DanielPedroElias/Microscopia-Openflerure---UFMT/ImpressaoBaixoCusto/PecasEditadas/actuator_assembly_toolsPart2_1.stl

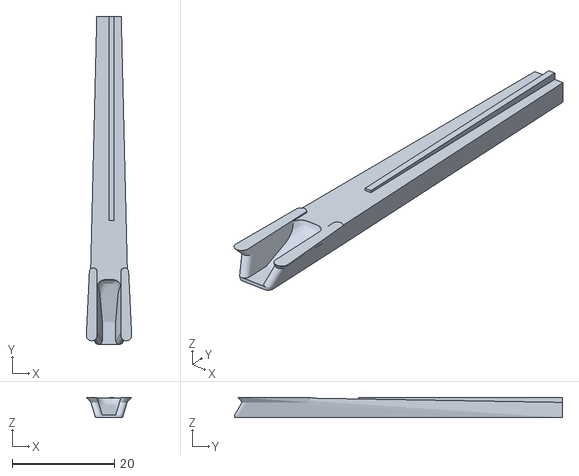
[picture p1: CAD file, 2026-11-10]
ImpressaoBaixoCusto/PecasEditadas/actuator_assembly_toolsPart2_1.stl
8.90 x 64.2 x 4.00
