DanielPedroElias/Microscopia-Openflerure---UFMT/ImpressãoMicManual/PecasEditadas/actuator_assembly_toolsPart1.stl

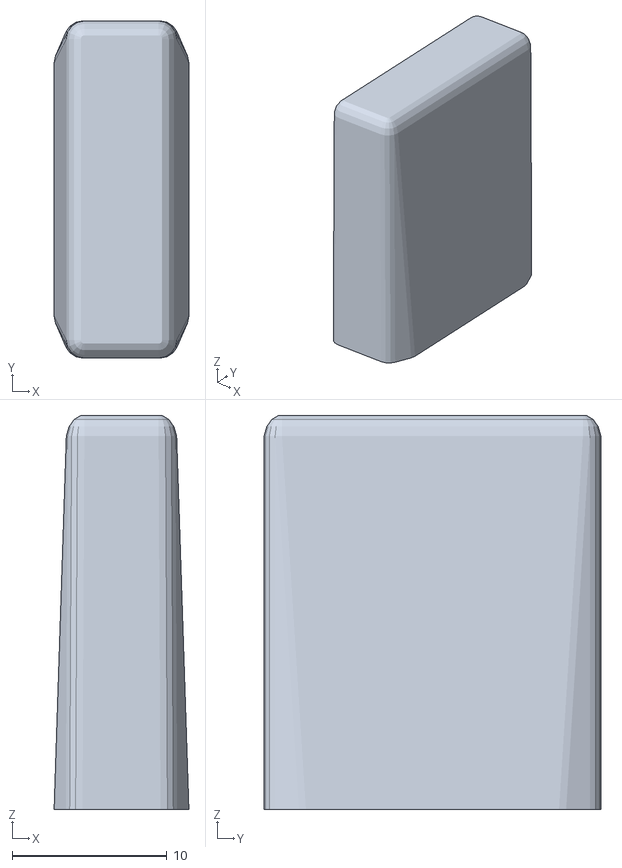
[picture p2: CAD file, 2026-11-10]
ImpressãoMicManual/PecasEditadas/actuator_assembly_toolsPart1.stl
8.72 x 21.8 x 25.5
