DanielPedroElias/Microscopia-Openflerure---UFMT/ImpressãoMicManual/PecasEditadas/actuator_assembly_toolsPart3.stl

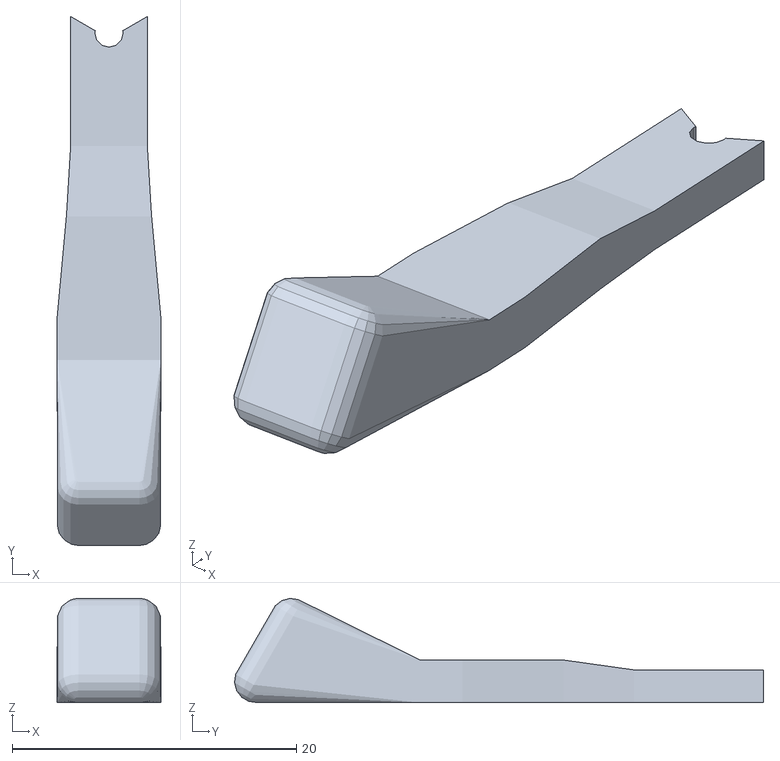
[picture p3: CAD file, 2026-11-10]
ImpressãoMicManual/PecasEditadas/actuator_assembly_toolsPart3.stl
7.30 x 37.2 x 7.33
