DanielPedroElias/Microscopia-Openflerure---UFMT/ImpressaoBaixoCusto/models/actuator_assembly_tools.stl

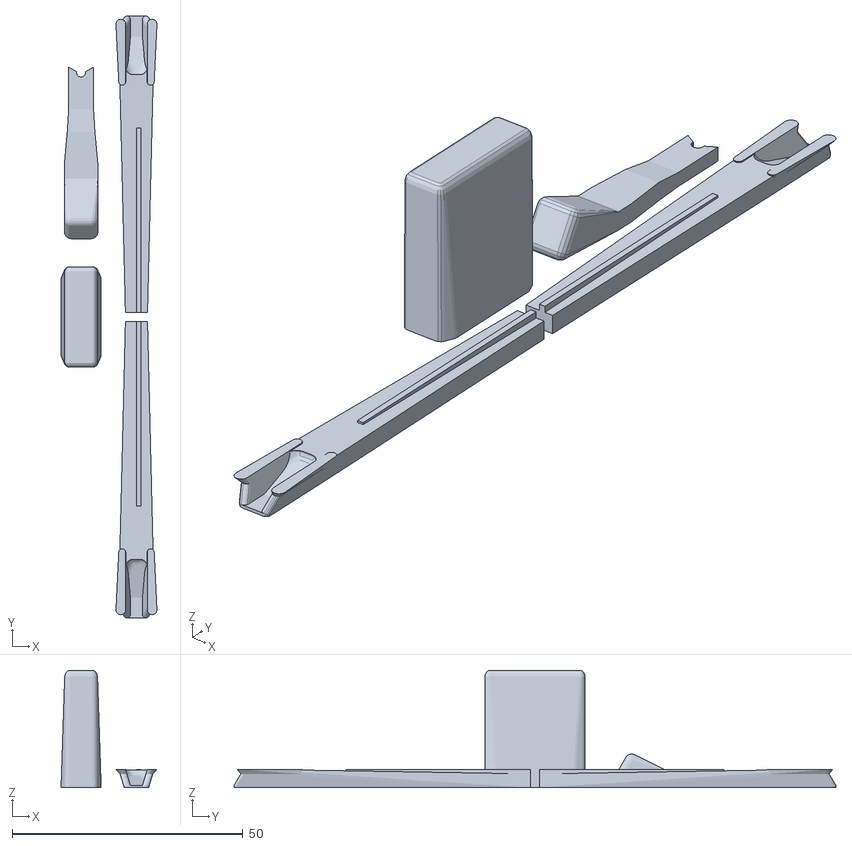
[picture p4: CAD file, 2026-11-10]
ImpressaoBaixoCusto/models/actuator_assembly_tools.stl
20.8 x 130.5 x 25.5
