DanielPedroElias/Microscopia-Openflerure---UFMT/ImpressãoMicManual/models/main_body_manual.stl

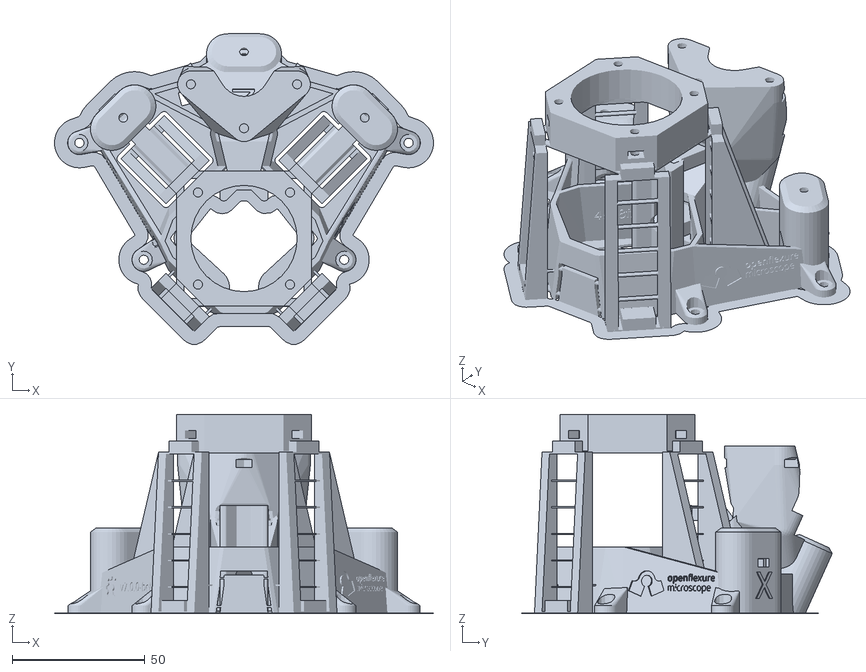
[picture p5: CAD file, 2026-11-10]
ImpressãoMicManual/models/main_body_manual.stl
142.6 x 116.8 x 75.0
