DanielPedroElias/Microscopia-Openflerure---UFMT/ImpressaoBaixoCusto/models/main_body.stl

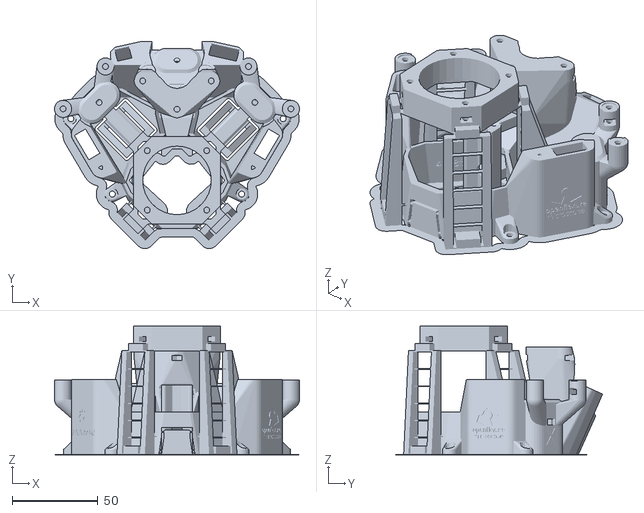
[picture p6: CAD file, 2026-11-10]
ImpressaoBaixoCusto/models/main_body.stl
142.9 x 120.9 x 75.0
