DanielPedroElias/Microscopia-Openflerure---UFMT/ImpressaoBaixoCusto/adaptacoes/condenser_led_holder.stl

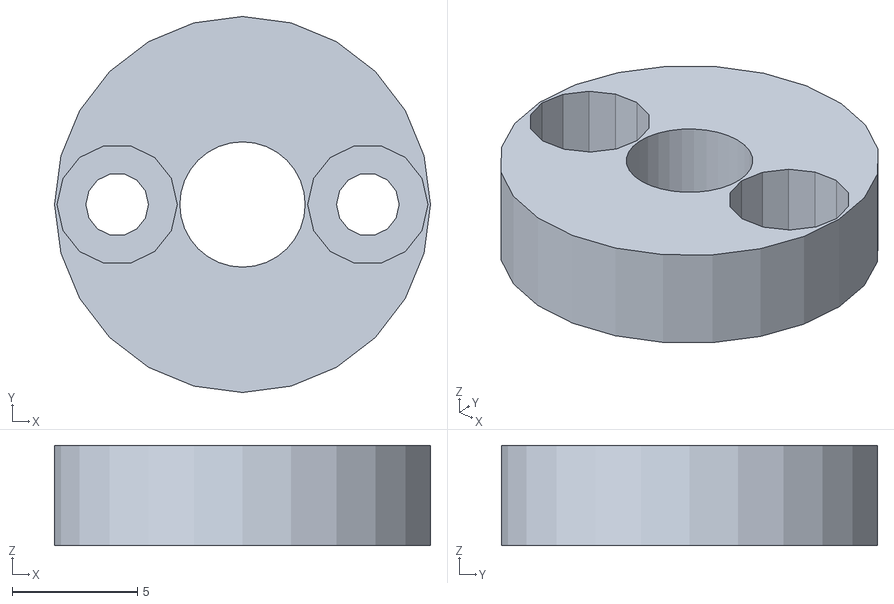
[picture p7: CAD file, 2026-11-10]
ImpressaoBaixoCusto/adaptacoes/condenser_led_holder.stl
15.0 x 15.0 x 4.00
