DanielPedroElias/Microscopia-Openflerure---UFMT/ImpressaoBaixoCusto/models/condenser.stl

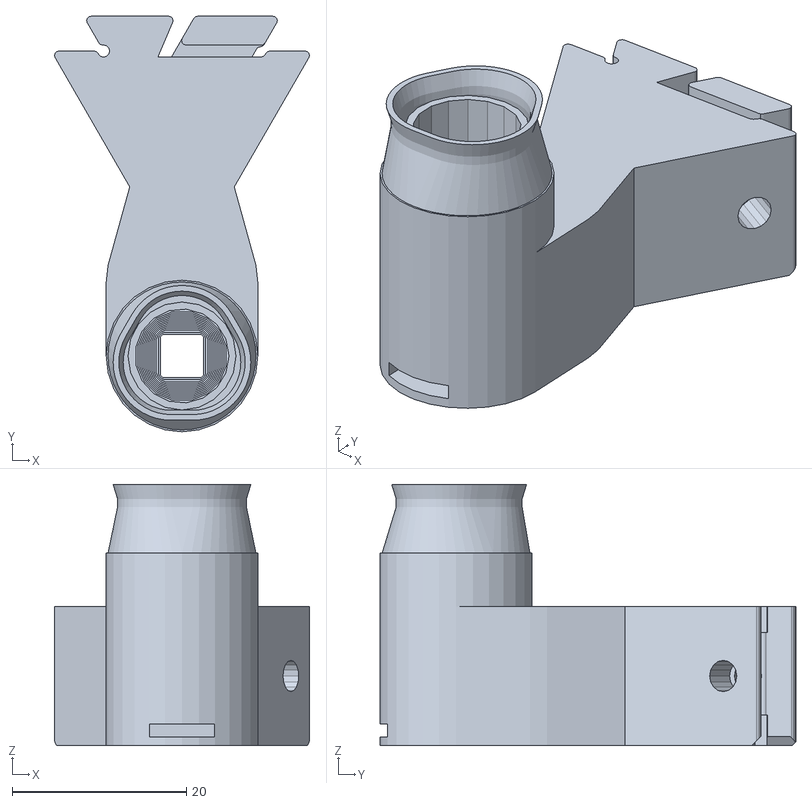
[picture p8: CAD file, 2026-11-10]
ImpressaoBaixoCusto/models/condenser.stl
29.3 x 47.7 x 30.0
