DanielPedroElias/Microscopia-Openflerure---UFMT/ImpressãoMicManual/models/feet.stl

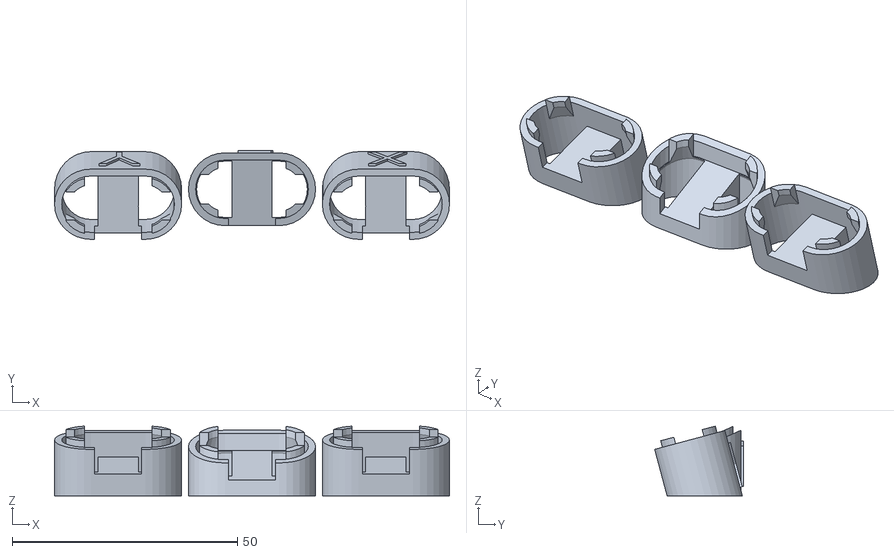
[picture p9: CAD file, 2026-11-10]
ImpressãoMicManual/models/feet.stl
87.6 x 19.7 x 15.5
