DanielPedroElias/Microscopia-Openflerure---UFMT/ImpressãoMicManual/PecasEditadas/feetX.stl

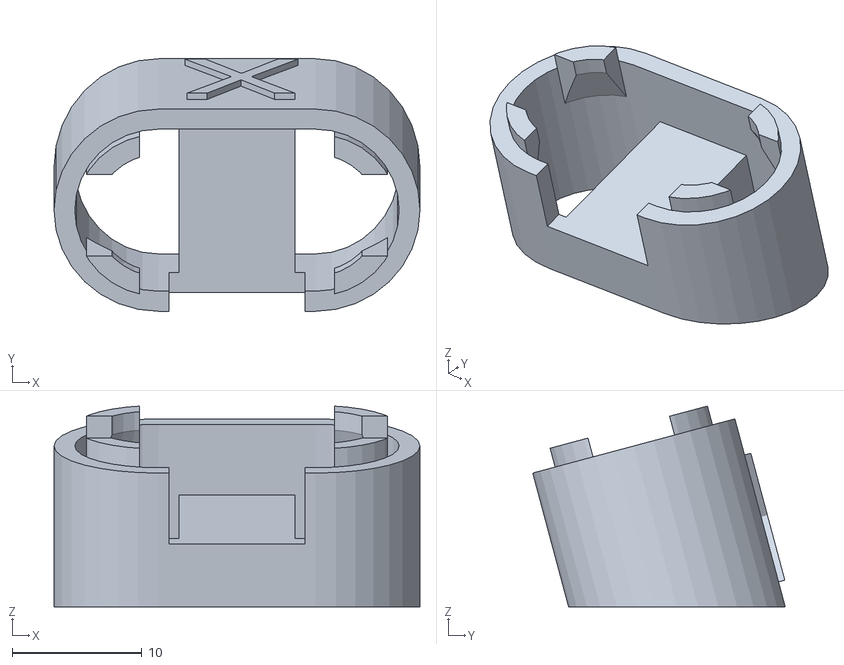
[picture p10: CAD file, 2026-11-10]
ImpressãoMicManual/PecasEditadas/feetX.stl
28.2 x 19.5 x 15.5
