DanielPedroElias/Microscopia-Openflerure---UFMT/ImpressaoBaixoCusto/adaptacoes/nano_converter_plate_gripper.stl

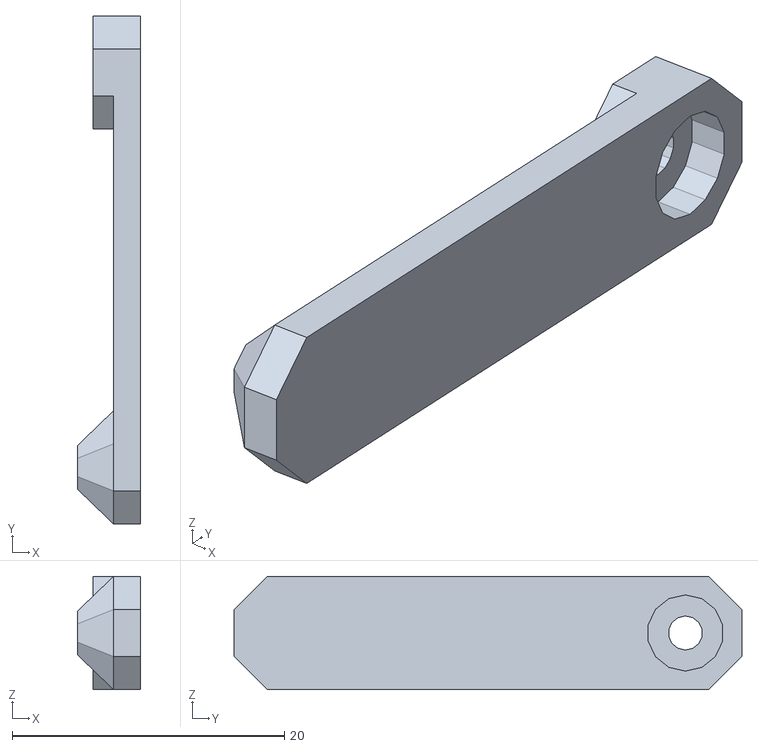
[picture p11: CAD file, 2026-11-10]
ImpressaoBaixoCusto/adaptacoes/nano_converter_plate_gripper.stl
4.66 x 37.3 x 8.31
