DanielPedroElias/Microscopia-Openflerure---UFMT/ImpressaoBaixoCusto/models/small_gears.stl

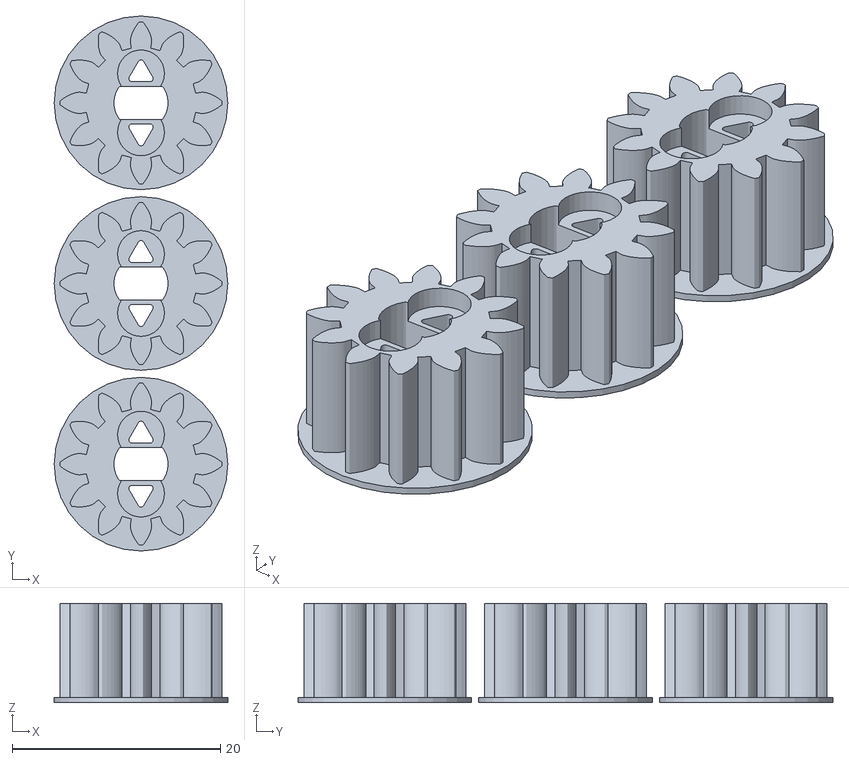
[picture p12: CAD file, 2026-11-10]
ImpressaoBaixoCusto/models/small_gears.stl
16.7 x 51.3 x 9.50
