DanielPedroElias/Microscopia-Openflerure---UFMT/ImpressaoBaixoCusto/PecasEditadas/GearToolsPart1.stl

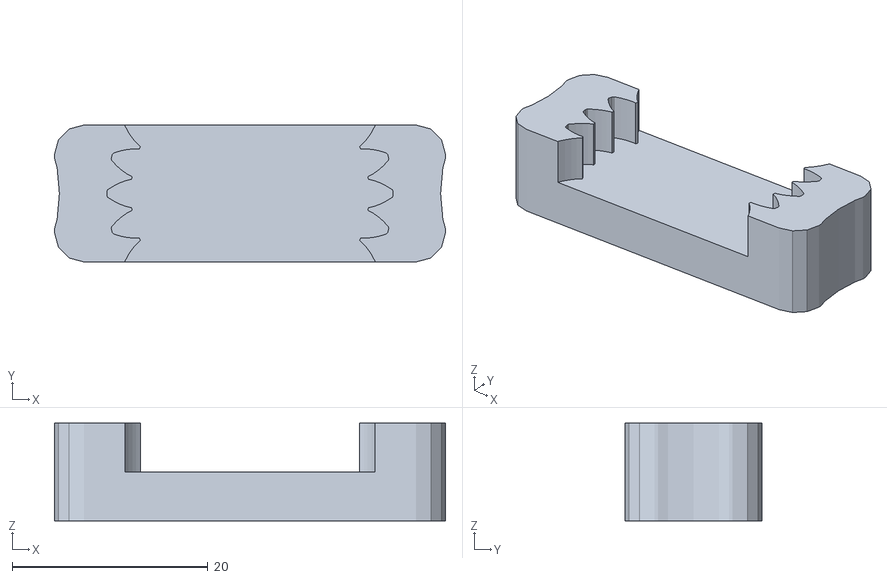
[picture p13: CAD file, 2026-11-10]
ImpressaoBaixoCusto/PecasEditadas/GearToolsPart1.stl
40.0 x 14.0 x 10.0
