DanielPedroElias/Microscopia-Openflerure---UFMT/ImpressaoBaixoCusto/adaptacoes/nano_converter_plate-pi4.stl

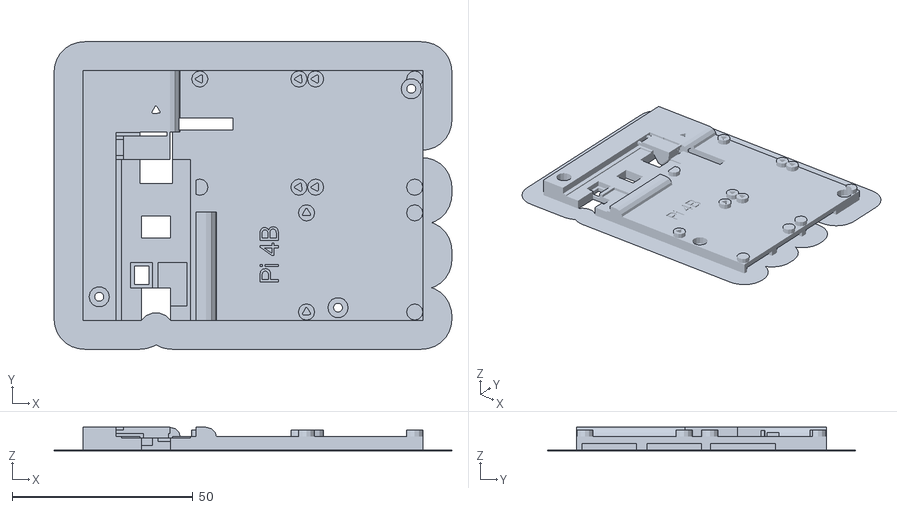
[picture p14: CAD file, 2026-11-10]
ImpressaoBaixoCusto/adaptacoes/nano_converter_plate-pi4.stl
110.0 x 85.0 x 6.50
