DanielPedroElias/Microscopia-Openflerure---UFMT/ImpressaoBaixoCusto/PecasEditadas/cable_tidiesPart2_1.stl

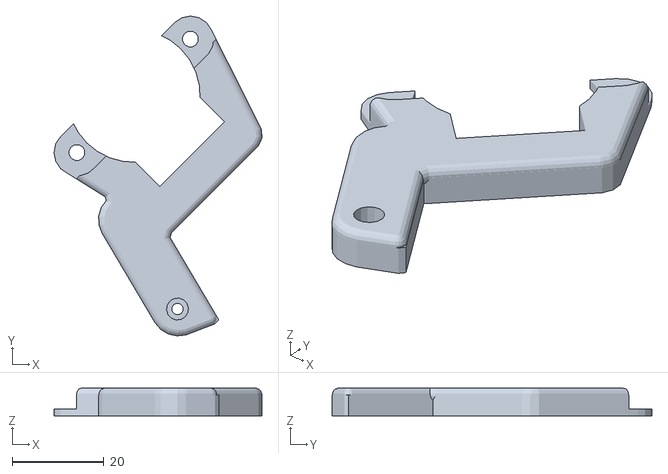
[picture p15: CAD file, 2026-11-10]
ImpressaoBaixoCusto/PecasEditadas/cable_tidiesPart2_1.stl
45.4 x 69.7 x 6.02
