DanielPedroElias/Microscopia-Openflerure---UFMT/ImpressãoMicManual/models/simple_post_stand.stl

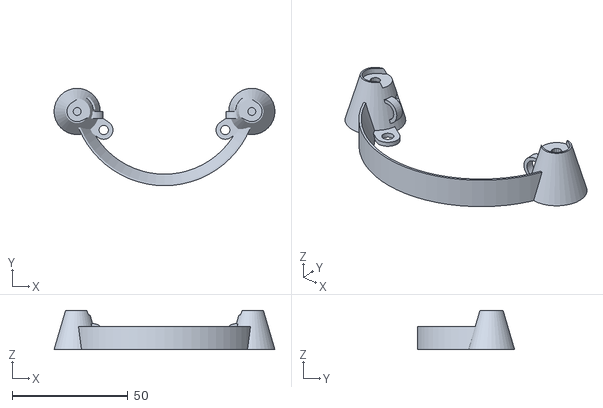
[picture p16: CAD file, 2026-11-10]
ImpressãoMicManual/models/simple_post_stand.stl
95.4 x 42.1 x 17.0
