DanielPedroElias/Microscopia-Openflerure---UFMT/ImpressãoMicManual/PecasEditadas/feetZ.stl

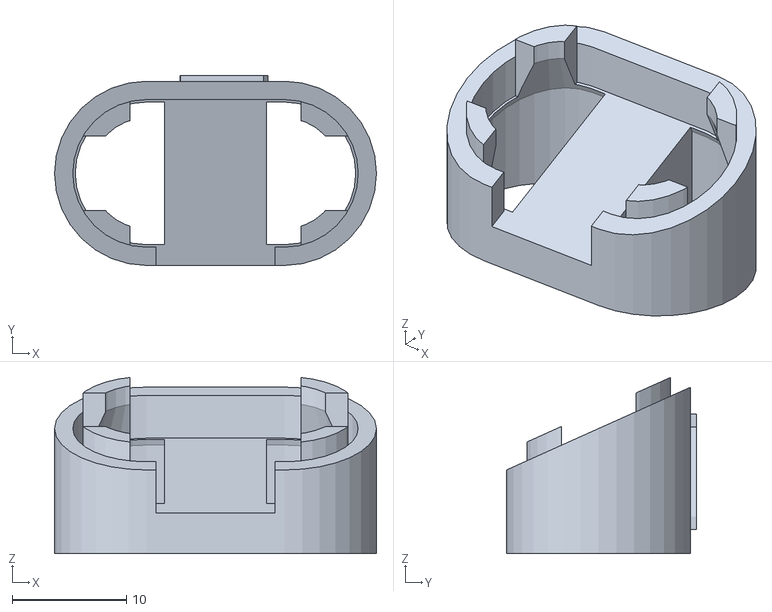
[picture p17: CAD file, 2026-11-10]
ImpressãoMicManual/PecasEditadas/feetZ.stl
28.2 x 16.6 x 15.4
