DanielPedroElias/Microscopia-Openflerure---UFMT/ImpressaoBaixoCusto/models/illumination_dovetail.stl

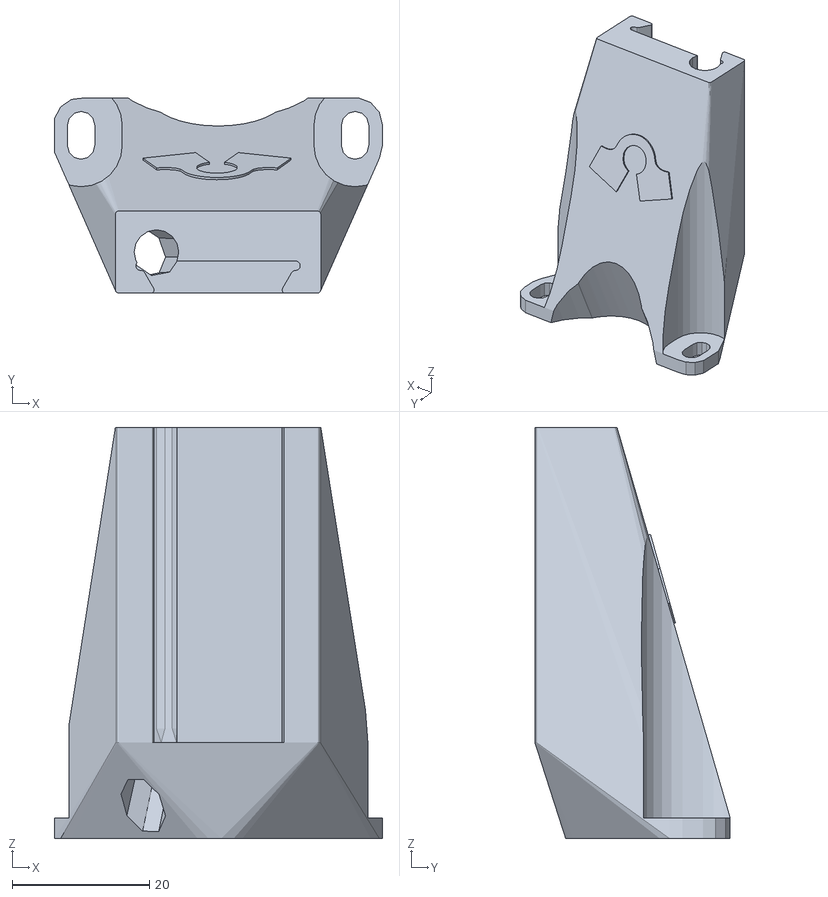
[picture p18: CAD file, 2026-11-10]
ImpressaoBaixoCusto/models/illumination_dovetail.stl
47.9 x 28.5 x 60.0
