DanielPedroElias/Microscopia-Openflerure---UFMT/ImpressãoMicManual/models/condenser_board_spacer.stl

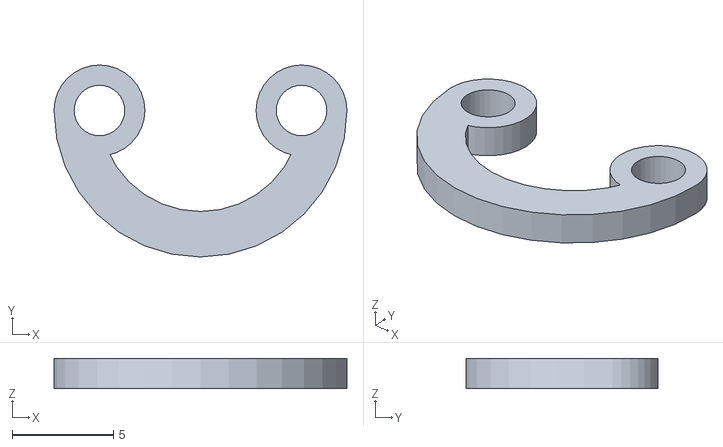
[picture p19: CAD file, 2026-11-10]
ImpressãoMicManual/models/condenser_board_spacer.stl
14.5 x 9.50 x 1.50
