DanielPedroElias/Microscopia-Openflerure---UFMT/ImpressãoMicManual/models/lens_tool.stl

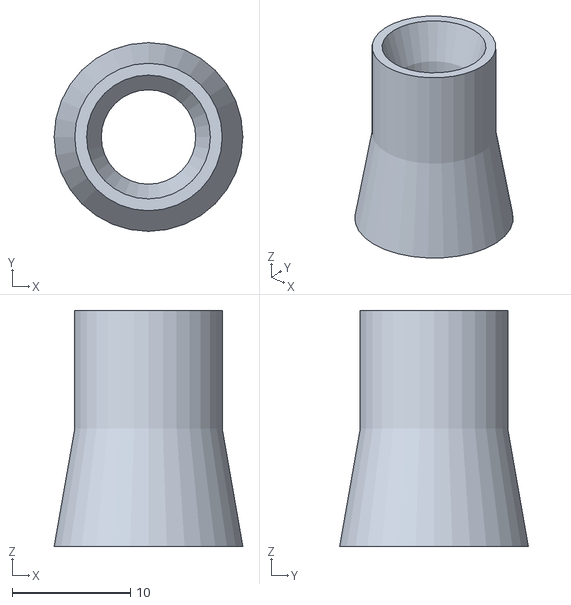
[picture p20: CAD file, 2026-11-10]
ImpressãoMicManual/models/lens_tool.stl
16.0 x 16.0 x 20.0
