DanielPedroElias/Microscopia-Openflerure---UFMT/ImpressaoBaixoCusto/models/camera_platform_picamera_2_pilens.stl

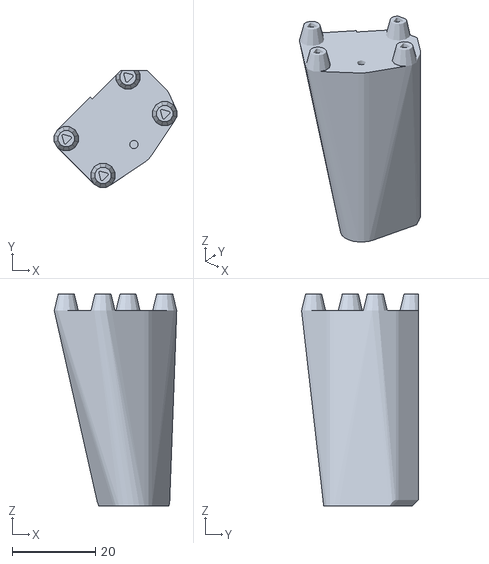
[picture p21: CAD file, 2026-11-10]
ImpressaoBaixoCusto/models/camera_platform_picamera_2_pilens.stl
29.5 x 28.1 x 51.0
