DanielPedroElias/Microscopia-Openflerure---UFMT/ImpressaoBaixoCusto/PecasEditadas/cable_tidiesPart1.stl

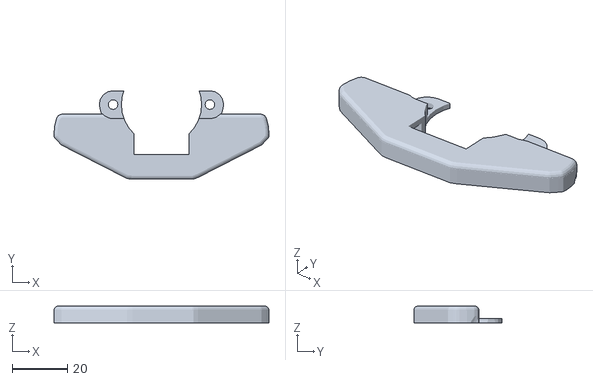
[picture p22: CAD file, 2026-11-10]
ImpressaoBaixoCusto/PecasEditadas/cable_tidiesPart1.stl
77.7 x 32.0 x 6.02
