DanielPedroElias/Microscopia-Openflerure---UFMT/ImpressãoMicManual/models/camera_platform_c270.stl

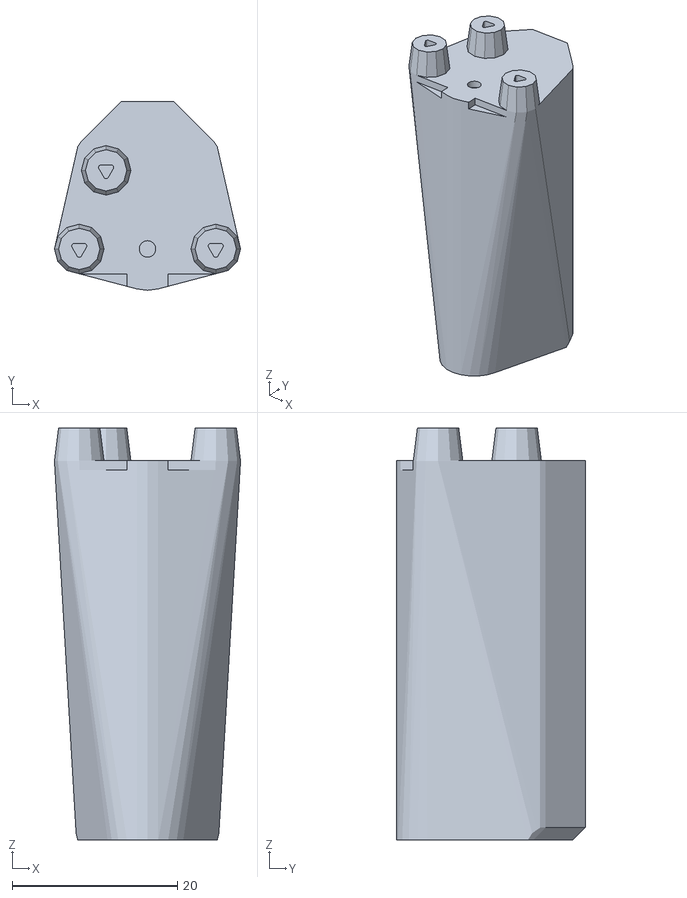
[picture p23: CAD file, 2026-11-10]
ImpressãoMicManual/models/camera_platform_c270.stl
22.5 x 22.8 x 49.8
