DanielPedroElias/Microscopia-Openflerure---UFMT/ImpressaoBaixoCusto/models/electronics_drawer-pi4_sanga_stack_11mm.stl

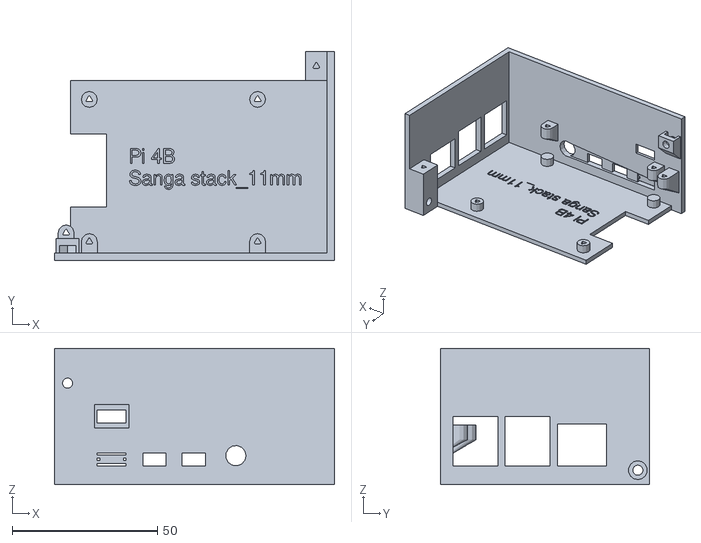
[picture p24: CAD file, 2026-11-10]
ImpressaoBaixoCusto/models/electronics_drawer-pi4_sanga_stack_11mm.stl
96.5 x 72.0 x 47.0
