DanielPedroElias/Microscopia-Openflerure---UFMT/ImpressaoBaixoCusto/PecasEditadas/uniqueSmallGear.stl

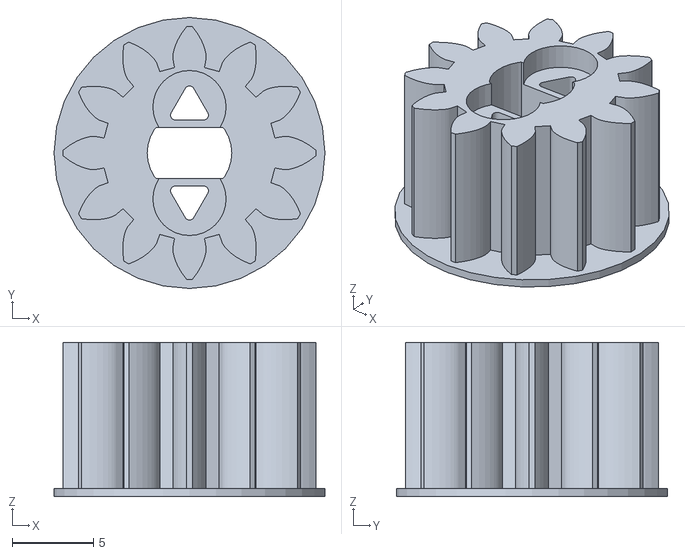
[picture p25: CAD file, 2026-11-10]
ImpressaoBaixoCusto/PecasEditadas/uniqueSmallGear.stl
16.7 x 16.7 x 9.50
