DanielPedroElias/Microscopia-Openflerure---UFMT/ImpressãoMicManual/models/microscope_stand_no_pi.stl

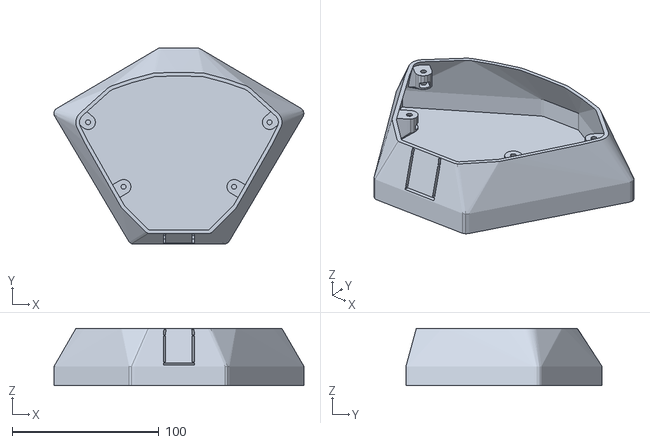
[picture p26: CAD file, 2026-11-10]
ImpressãoMicManual/models/microscope_stand_no_pi.stl
170.6 x 133.9 x 39.0
