DanielPedroElias/Microscopia-Openflerure---UFMT/ImpressãoMicManual/PecasEditadas/Uniquethumbwheels.stl

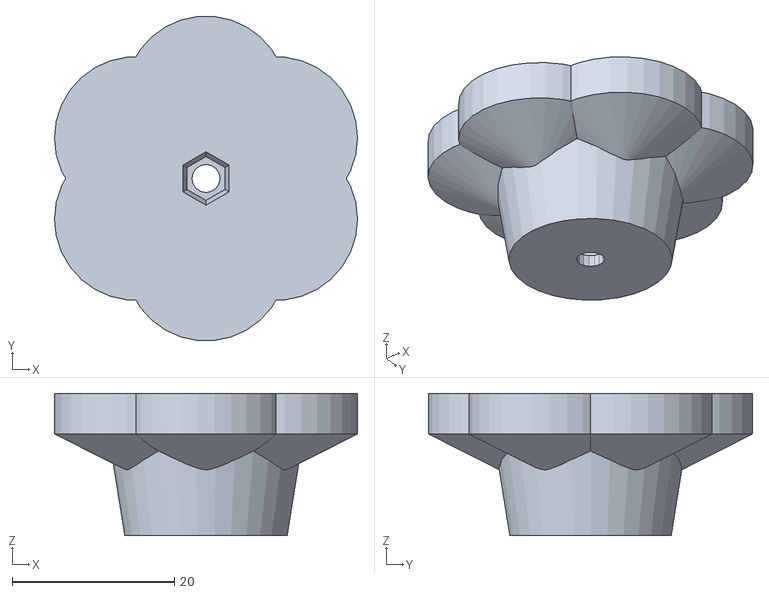
[picture p27: CAD file, 2026-11-10]
ImpressãoMicManual/PecasEditadas/Uniquethumbwheels.stl
37.3 x 39.9 x 17.5
