DanielPedroElias/Microscopia-Openflerure---UFMT/ImpressaoBaixoCusto/models/lens_spacer_picamera_2_pilens.stl

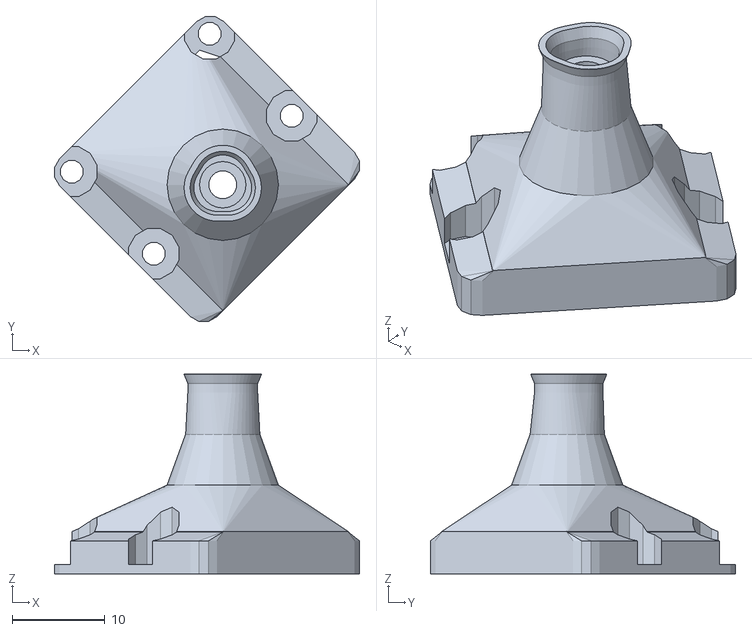
[picture p28: CAD file, 2026-11-10]
ImpressaoBaixoCusto/models/lens_spacer_picamera_2_pilens.stl
32.9 x 32.9 x 21.5
