DanielPedroElias/Microscopia-Openflerure---UFMT/ImpressaoBaixoCusto/PecasEditadas/uniqueLargeGear.stl

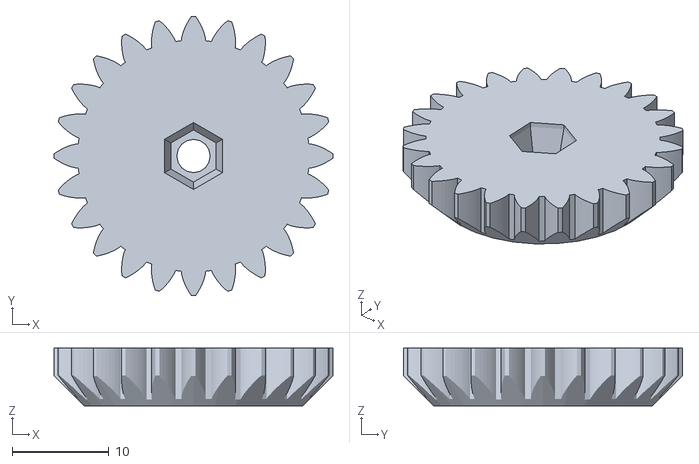
[picture p29: CAD file, 2026-11-10]
ImpressaoBaixoCusto/PecasEditadas/uniqueLargeGear.stl
28.9 x 28.9 x 6.00
