DanielPedroElias/Microscopia-Openflerure---UFMT/ImpressaoBaixoCusto/models/large_gears.stl

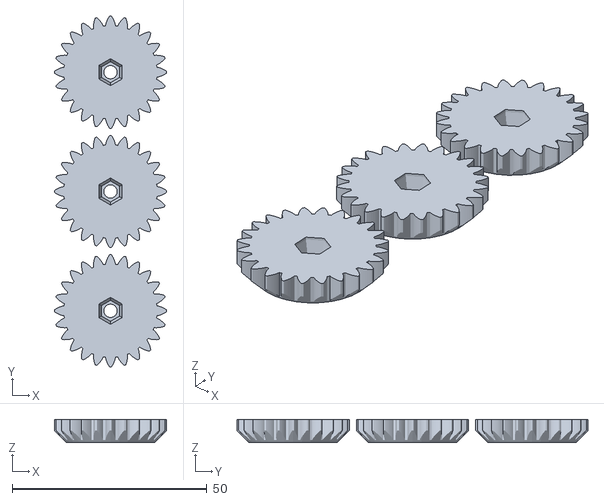
[picture p30: CAD file, 2026-11-10]
ImpressaoBaixoCusto/models/large_gears.stl
28.9 x 90.2 x 6.00
