DanielPedroElias/Microscopia-Openflerure---UFMT/ImpressãoMicManual/models/thumbwheels.stl

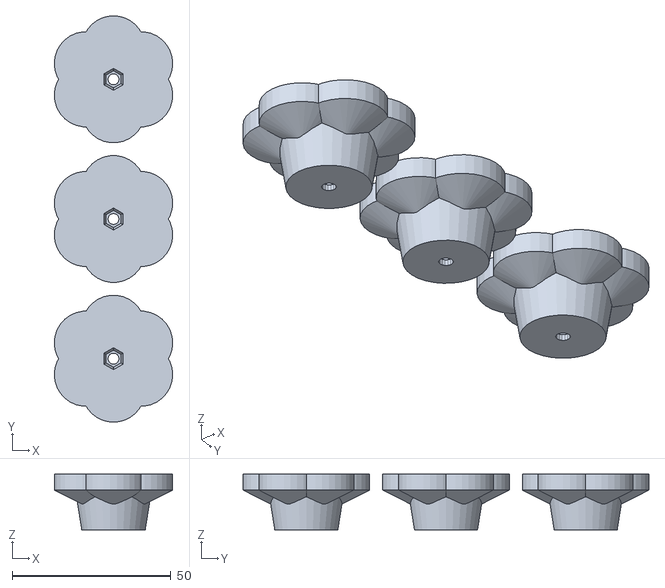
[picture p31: CAD file, 2026-11-10]
ImpressãoMicManual/models/thumbwheels.stl
37.3 x 127.9 x 17.5
