DanielPedroElias/Microscopia-Openflerure---UFMT/ImpressaoBaixoCusto/models/sample_clips.stl

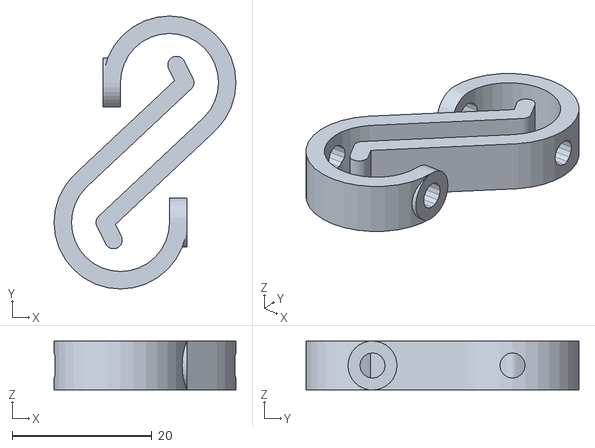
[picture p32: CAD file, 2026-11-10]
ImpressaoBaixoCusto/models/sample_clips.stl
26.0 x 39.0 x 7.00
