DanielPedroElias/Microscopia-Openflerure---UFMT/ImpressãoMicManual/models/c270_camera_backshell.stl

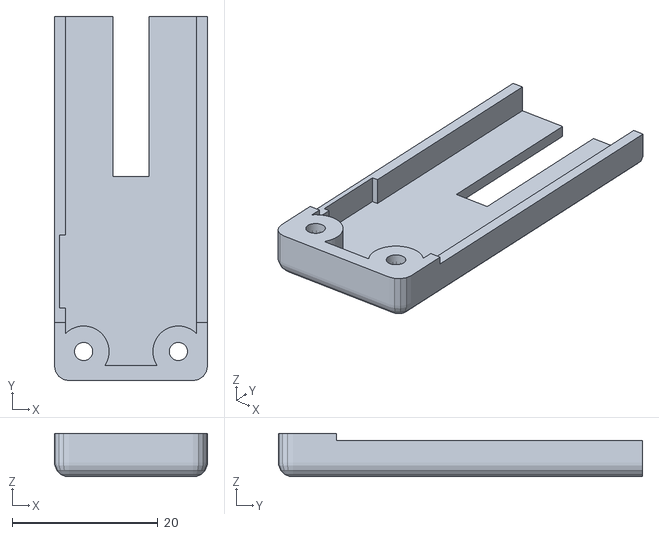
[picture p33: CAD file, 2026-11-10]
ImpressãoMicManual/models/c270_camera_backshell.stl
21.0 x 50.0 x 5.96
