DanielPedroElias/Microscopia-Openflerure---UFMT/ImpressaoBaixoCusto/models/gear_tools.stl

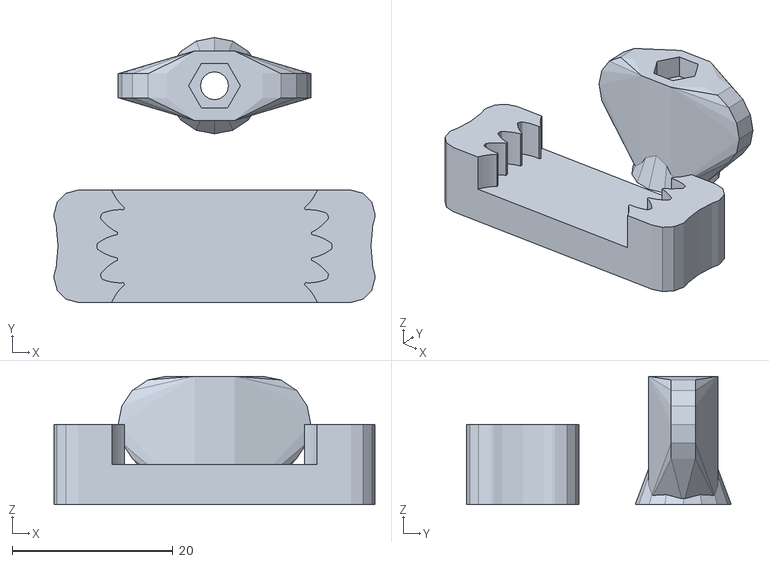
[picture p34: CAD file, 2026-11-10]
ImpressaoBaixoCusto/models/gear_tools.stl
40.0 x 33.0 x 16.0
