DanielPedroElias/Microscopia-Openflerure---UFMT/ImpressaoBaixoCusto/PecasEditadas/GearToolsPart2.stl

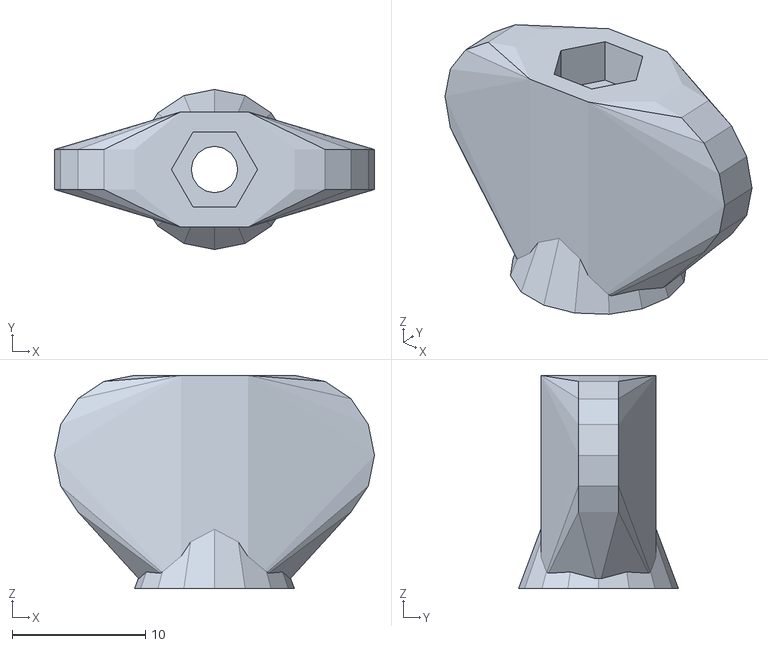
[picture p35: CAD file, 2026-11-10]
ImpressaoBaixoCusto/PecasEditadas/GearToolsPart2.stl
24.0 x 12.0 x 16.0
