DanielPedroElias/Microscopia-Openflerure---UFMT/ImpressãoMicManual/models/condenser_lid.stl

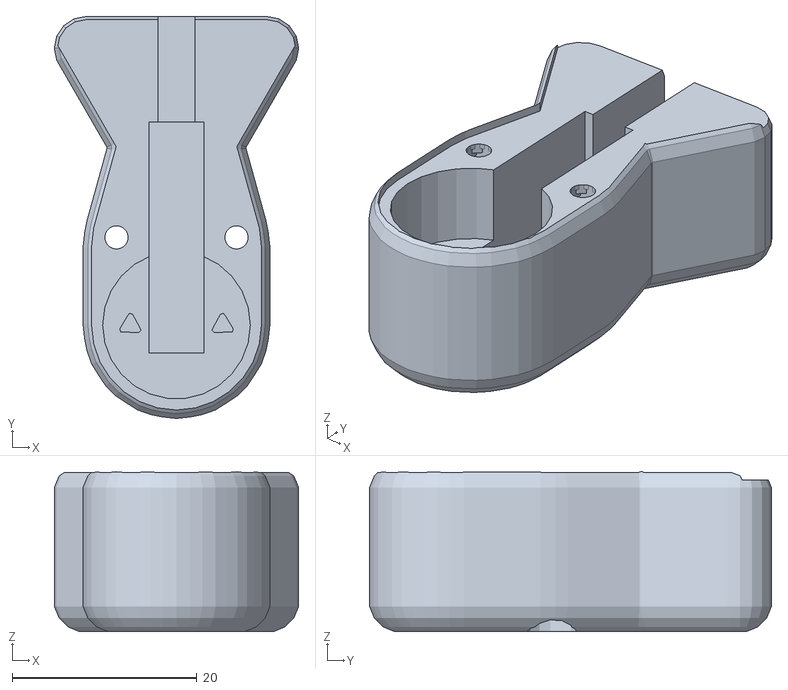
[picture p36: CAD file, 2026-11-10]
ImpressãoMicManual/models/condenser_lid.stl
26.5 x 43.6 x 17.4
