DanielPedroElias/Microscopia-Openflerure---UFMT/ImpressaoBaixoCusto/models/cable_tidies.stl

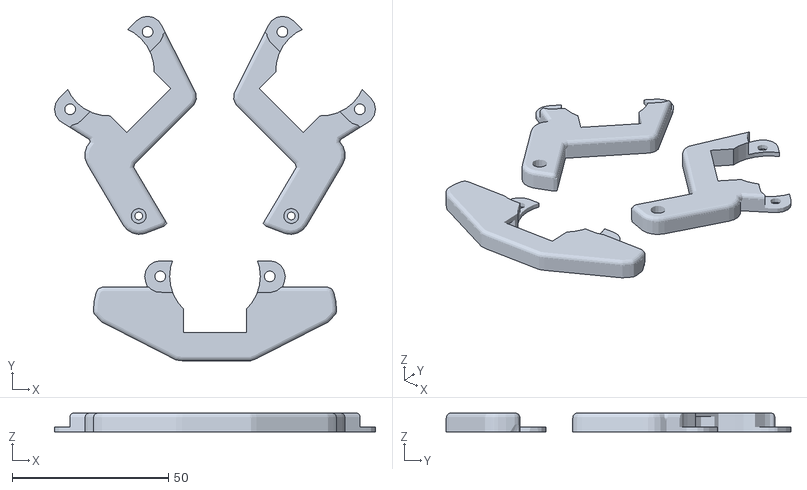
[picture p37: CAD file, 2026-11-10]
ImpressaoBaixoCusto/models/cable_tidies.stl
102.6 x 110.2 x 6.03
