DanielPedroElias/Microscopia-Openflerure---UFMT/ImpressaoBaixoCusto/models/microscope_stand.stl

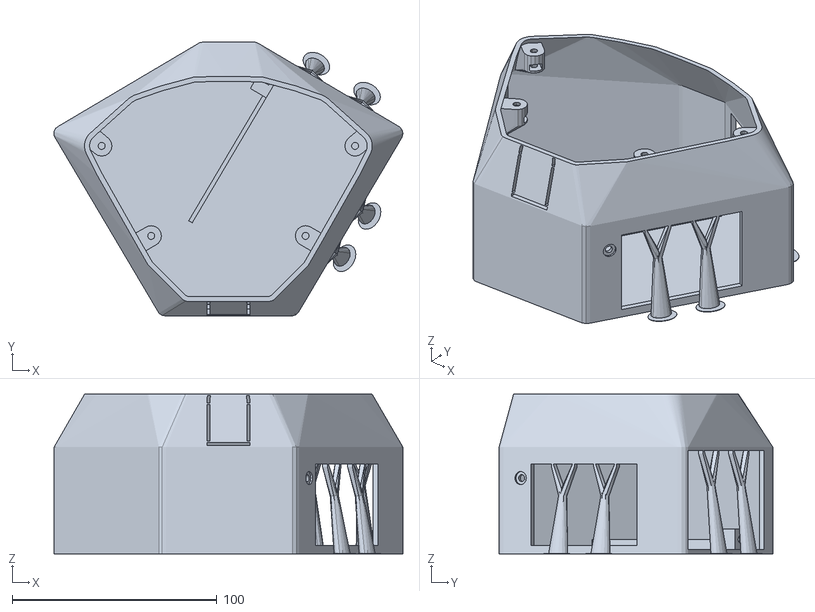
[picture p38: CAD file, 2026-11-10]
ImpressaoBaixoCusto/models/microscope_stand.stl
170.6 x 133.9 x 78.0
