DanielPedroElias/Microscopia-Openflerure---UFMT/ImpressãoMicManual/models/lens_spacer_c270.stl

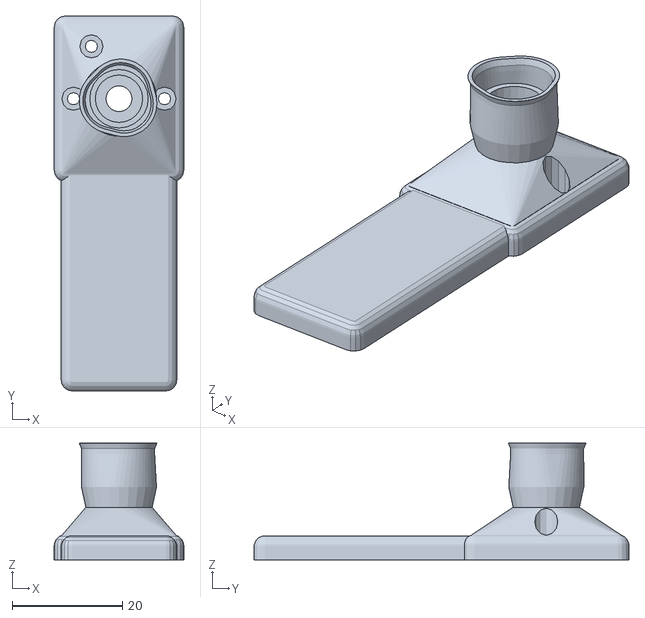
[picture p39: CAD file, 2026-11-10]
ImpressãoMicManual/models/lens_spacer_c270.stl
23.5 x 68.0 x 21.2
