DanielPedroElias/Microscopia-Openflerure---UFMT/(list of files, cad)

Other CAD files:
ImpressaoBaixoCusto/PecasEditadas/actuator_assembly_toolsPart2_2.stl
ImpressãoMicManual/PecasEditadas/actuator_assembly_toolsPart2_2.stl
ImpressaoBaixoCusto/PecasEditadas/feetY.stl
ImpressãoMicManual/PecasEditadas/feetY.stl
ImpressaoBaixoCusto/PecasEditadas/feetZ.stl
ImpressaoBaixoCusto/PecasEditadas/cable_tidiesPart2_2.stl
ImpressaoBaixoCusto/models/illumination_thumbscrew.stl
ImpressãoMicManual/models/illumination_thumbscrew.stl
